joe-eldridge/stm32_cpp_environment_monitor/Core/Inc/main.h

#define B1_Pin GPIO_PIN_13
#define B1_GPIO_Port GPIOC
#define MCO_Pin GPIO_PIN_0
#define MCO_GPIO_Port GPIOH
#define DS3231_SQW_Pin GPIO_PIN_0
#define DS3231_SQW_GPIO_Port GPIOC
#define DS3231_SQW_EXTI_IRQn EXTI0_1_IRQn
#define ENC_CLK_Pin GPIO_PIN_1
#define ENC_CLK_GPIO_Port GPIOC
#define ENC_CLK_EXTI_IRQn EXTI0_1_IRQn
#define ENC_DT_Pin GPIO_PIN_2
#define ENC_DT_GPIO_Port GPIOC
#define ENC_DT_EXTI_IRQn EXTI2_3_IRQn
#define ENC_SW_Pin GPIO_PIN_3
#define ENC_SW_GPIO_Port GPIOC
#define ENC_SW_EXTI_IRQn EXTI2_3_IRQn
#define USART_TX_Pin GPIO_PIN_2
#define USART_TX_GPIO_Port GPIOA
#define USART_RX_Pin GPIO_PIN_3
#define USART_RX_GPIO_Port GPIOA
#define LD2_Pin GPIO_PIN_5
#define LD2_GPIO_Port GPIOA
#define eInk_D_C_Pin GPIO_PIN_10
#define eInk_D_C_GPIO_Port GPIOB
#define SRAM_CS_Pin GPIO_PIN_7
#define SRAM_CS_GPIO_Port GPIOC
#define eInk_CS_Pin GPIO_PIN_8
#define eInk_CS_GPIO_Port GPIOA
#define SD_CS_Pin GPIO_PIN_10
#define SD_CS_GPIO_Port GPIOA
#define TMS_Pin GPIO_PIN_13
#define TMS_GPIO_Port GPIOA
#define TCK_Pin GPIO_PIN_14
#define TCK_GPIO_Port GPIOA
#define eInk_RST_Pin GPIO_PIN_4
#define eInk_RST_GPIO_Port GPIOB
#define eInk_BUSY_Pin GPIO_PIN_5
#define eInk_BUSY_GPIO_Port GPIOB
