joe-eldridge/stm32_cpp_environment_monitor/(commit log)

2026-09-16 Add STM32CubeMX project for STM32L073RZ
2026-09-16 Add low-power sensor logging with C++ drivers
2026-09-16 Reduce MCU awake time and Stop-mode current
2026-09-16 Note eInk board revision in README
2026-09-17 Add SSD1681 e-paper driver and framebuffer with tests
2026-09-17 Add main screen and draw it after every sample
2026-09-17 Average samples by the hour and keep a day of them
2026-09-17 Add rotary encoder decoding and button debouncing
2026-09-17 Add button menu for setting the time and managing the card
2026-09-18 Let SPI finish its frame before changing the prescaler
    Clearing SPE part way through a frame stops the clock mid-byte and leaves
    the peripheral and the device out of step. Wait for TXE and for BSY to
    clear first, as the reference manual requires. This corrupted SD writes
    and lost display commands, and only became reliably visible once the
    Debug build was optimised.
2026-09-18 Build Debug at -Og
    At -O0 a byte through SPI cost around 480 cycles against 16 for the
    transfer itself, so a 5KB image took a second. The Clang toolchain file
    alongside already used -Og.
2026-09-18 Stop a blocked poll being read as a long press
    A panel refresh blocks for about a second, during which the button isn't
    sampled. On return the gap read as a hold, which closed the menu the
    moment it opened. Button::Reset adopts the current level without
    reporting anything.
    [main_screen.cpp, test_button.cpp, test_text_format.cpp, text_format.cpp, text_format.hpp]
2026-09-18 Fix SD card init: idle clocks between commands, in-spec init clock
    Send eight idle clocks before each command, as the spec requires between
    a response and the next command: without them a card still releasing the
    line misreads the frame and answers with half its error bits set. Also
    run identification at 262kHz, inside the 100-400kHz window rather than
    below it. One card worked throughout, another never did.
2026-09-18 Erase the log file instead of formatting the card
    The confirmation always said 'erase all logs', but f_mkfs rebuilt the
    filesystem: over ten minutes on a 16GB card at this bus speed, and forty
    on a 256GB one. Unlinking the file takes milliseconds. Cards are
    formatted on a PC.
2026-09-18 Wire up the menu: encoder interrupts, erase logs, card diagnostics
    Decode the encoder in its EXTI handler, so a detent turned during a
    refresh isn't lost, with the lines unmasked only while the menu is open.
    Report which step card init reached and how long it took.
2026-09-18 Send display image blocks to SPI over DMA
    Transmit and receive both run on DMA, receive into a single discarded
    byte, so the SPI is left drained for the SD card. Completion is polled:
    the generated DMA interrupt handler is empty.
2026-09-18 Document how the menu was made responsive, and what was dropped
    Each step was found by timing an update in parts. Waveshare's fast
    waveform measured 572ms against the built-in 596ms: frames are 20ms and
    about 230ms of every refresh is fixed cost, so it was removed.
